Expatria-Technologies/EST_Accessory_PCB/README.md

flag

# Elbows up.
