Expatria-Technologies/EST_Accessory_PCB/LIMIT_BREAKOUT/CAM_OUTPUTS/BOM/LIMIT_SW_Breakout_CAM_OUTPUT_A8.xlsx

Comment | Description | Designator | Footprint | SuppliersPartNumber | Quantity
0805 Green | LED | D24 | 0805_LED_S1 | C2297 | 1
0603 Yellow | LED | D25, D26, D27, D28 | 0603_LED_S1 | C72038 | 4
0603 White | LED | D29, D30 | 0603_LED_S1 | C2290 | 2
 | Header,Male Pin,Covered(4 Sided) 3 1 0.138"（3.50mm） 3 P=3.5mm Pluggable System Terminal Block RoHS | J17, J18, J19, J20, J21, J22 | SL_3_50_180G_03 | C192778 | 6
5555799-1 | CONN MOD JACK 8P8C VERT UNSHLD | J23 | FP-5555799-1-MFG | C305983 | 1
AP5N10S | N Mosfet | Q1, Q2 | SOT-23-3L | C2849571 | 2
MMBT5401 2L | 三极管 | Q3, Q4 | SOT-23(SOT-23-3) | C8326 | 2
100KΩ ±1% | Chip resistor | R1, R2 | 0603_R | C25803 | 2
2KΩ ±1% | Chip resistor | R3, R4, R79, R80, R81, R82, R83, R84 | 0603_R | C22975 | 8
10KΩ ±1% | Chip resistor | R78 | 0603_R | C25804 | 1
