Expatria-Technologies/EST_Accessory_PCB/USER_BREAKOUT/CAM_OUTPUTS/BOM/USER_SW_Breakout_CAM_OUTPUT_A7.xlsx

Comment | Description | Designator | Footprint | SuppliersPartNumber | Quantity
0603 Green | LED | D31 | 0603_LED_S1 | C72043 | 1
0603 Red | LED | D32 | 0603_LED_S1 | C2286 | 1
0603 Yellow | LED | D33, D34 | 0603_LED_S1 | C72038 | 2
RJHSE-5080 | CONN MOD JACK 8P8C R/A UNSHLD | J24 | FP-RJHSE-5080-MFG | C385834 | 1
AO3400A N | MOS(场效应管) | Q1, Q2, Q3 | SOT-23-3L | C700953 | 3
2KΩ ±1% | Chip resistor | R1, R2, R3, R85, R87, R89, R90 | 0603_R | C22975 | 7
K2-1102SP-C4SC-04 | Top Actuated 50mA @ 12VDC Round Button SPST 6*6mm Tactile Switches ROHS | SW1, SW2, SW3 | TECO-FSM4JSMATR_V | C127509 | 3
