Expatria-Technologies/EST_Accessory_PCB/LED_RING/LED_Ring_80mm.step

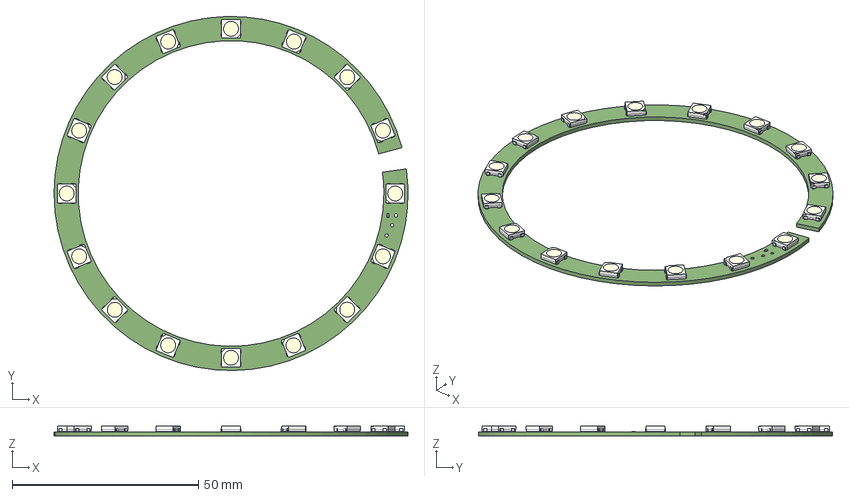
[picture p9: CAD file, 2025-03-02]
LED_RING/LED_Ring_80mm.step
95.0 x 95.0 x 2.77 mm
User_Library-WS2812B x 16
0402_SMD_Capacitor
