Expatria-Technologies/EST_Accessory_PCB/LIMIT_BREAKOUT/LIMIT_SW_Breakout.step

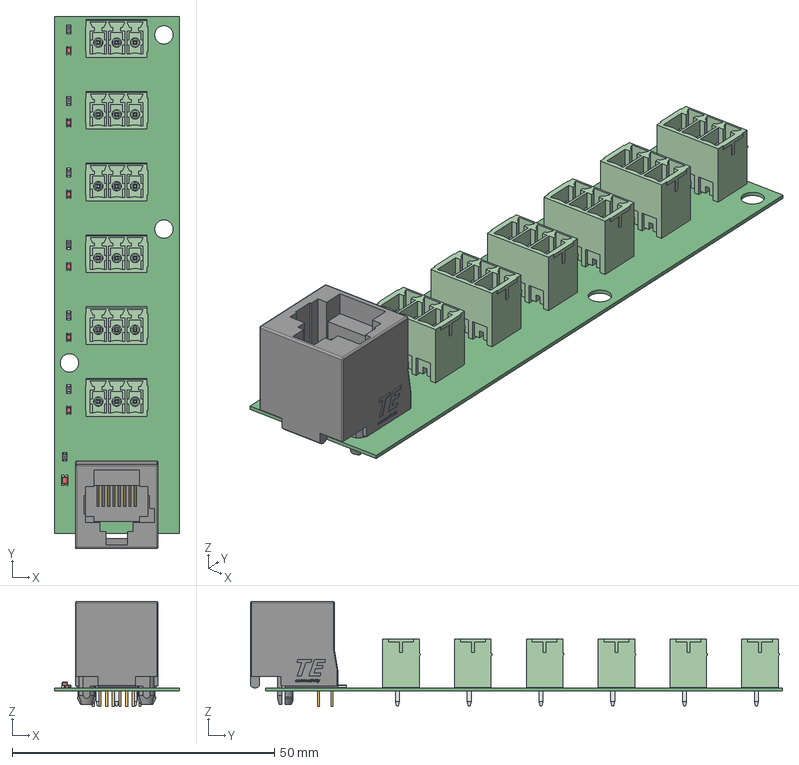
[picture p10: CAD file, 2023-08-02]
LIMIT_BREAKOUT/LIMIT_SW_Breakout.step
23.9 x 101.4 x 20.1 mm
plastic
pins_
User_Library-RES_1609-0603 x 7
6913211000xx_PIN x 18
User_Library-LED_0603_R_Pocket002 x 6
User_Library-LED_0603_R_Pad004 x 6
User_Library-LED_0603_R_Fillet x 6
User_Library-LED_0603_R_Pocket001 x 6
User_Library-LED_0603_R_Pad x 6
User_Library-led_0805
