Expatria-Technologies/EST_Accessory_PCB/USER_BREAKOUT/USER_SW_Breakout.step

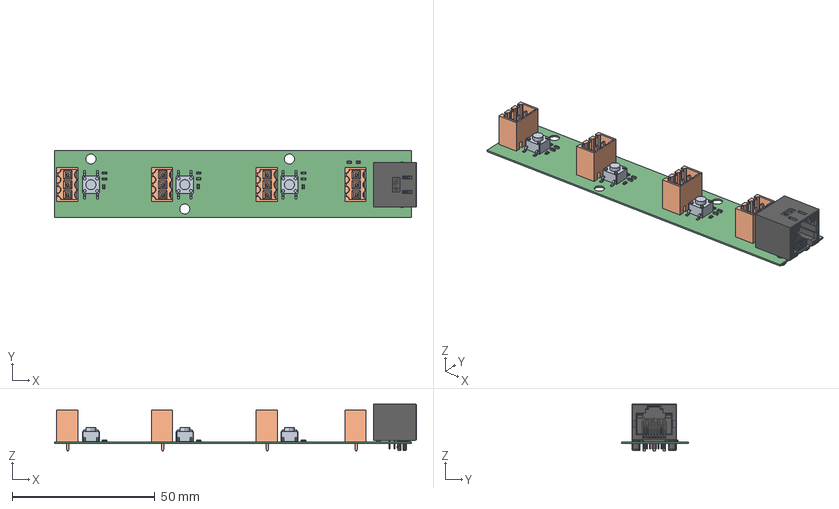
[picture p11: CAD file, 2023-08-02]
USER_BREAKOUT/USER_SW_Breakout.step
126.7 x 23.5 x 16.4 mm
Conn_Amphenol_RJHSE-5080_eec
c-4-1437565-2-s-3d x 3
User_Library-RES_1609-0603 x 7
SL_3.50_03_180G_3.2SN_OR_BX_1604480000 x 4
User_Library-LED_0603_R_Pocket002 x 4
User_Library-LED_0603_R_Pad004 x 4
User_Library-LED_0603_R_Fillet x 4
User_Library-LED_0603_R_Pocket001 x 4
User_Library-LED_0603_R_Pad x 4
