Expatria-Technologies/EST_Accessory_PCB/LIMIT_BREAKOUT/LIMIT_SW_Breakout_Schematic_A7_FULL_ASSEMBLY.PDF

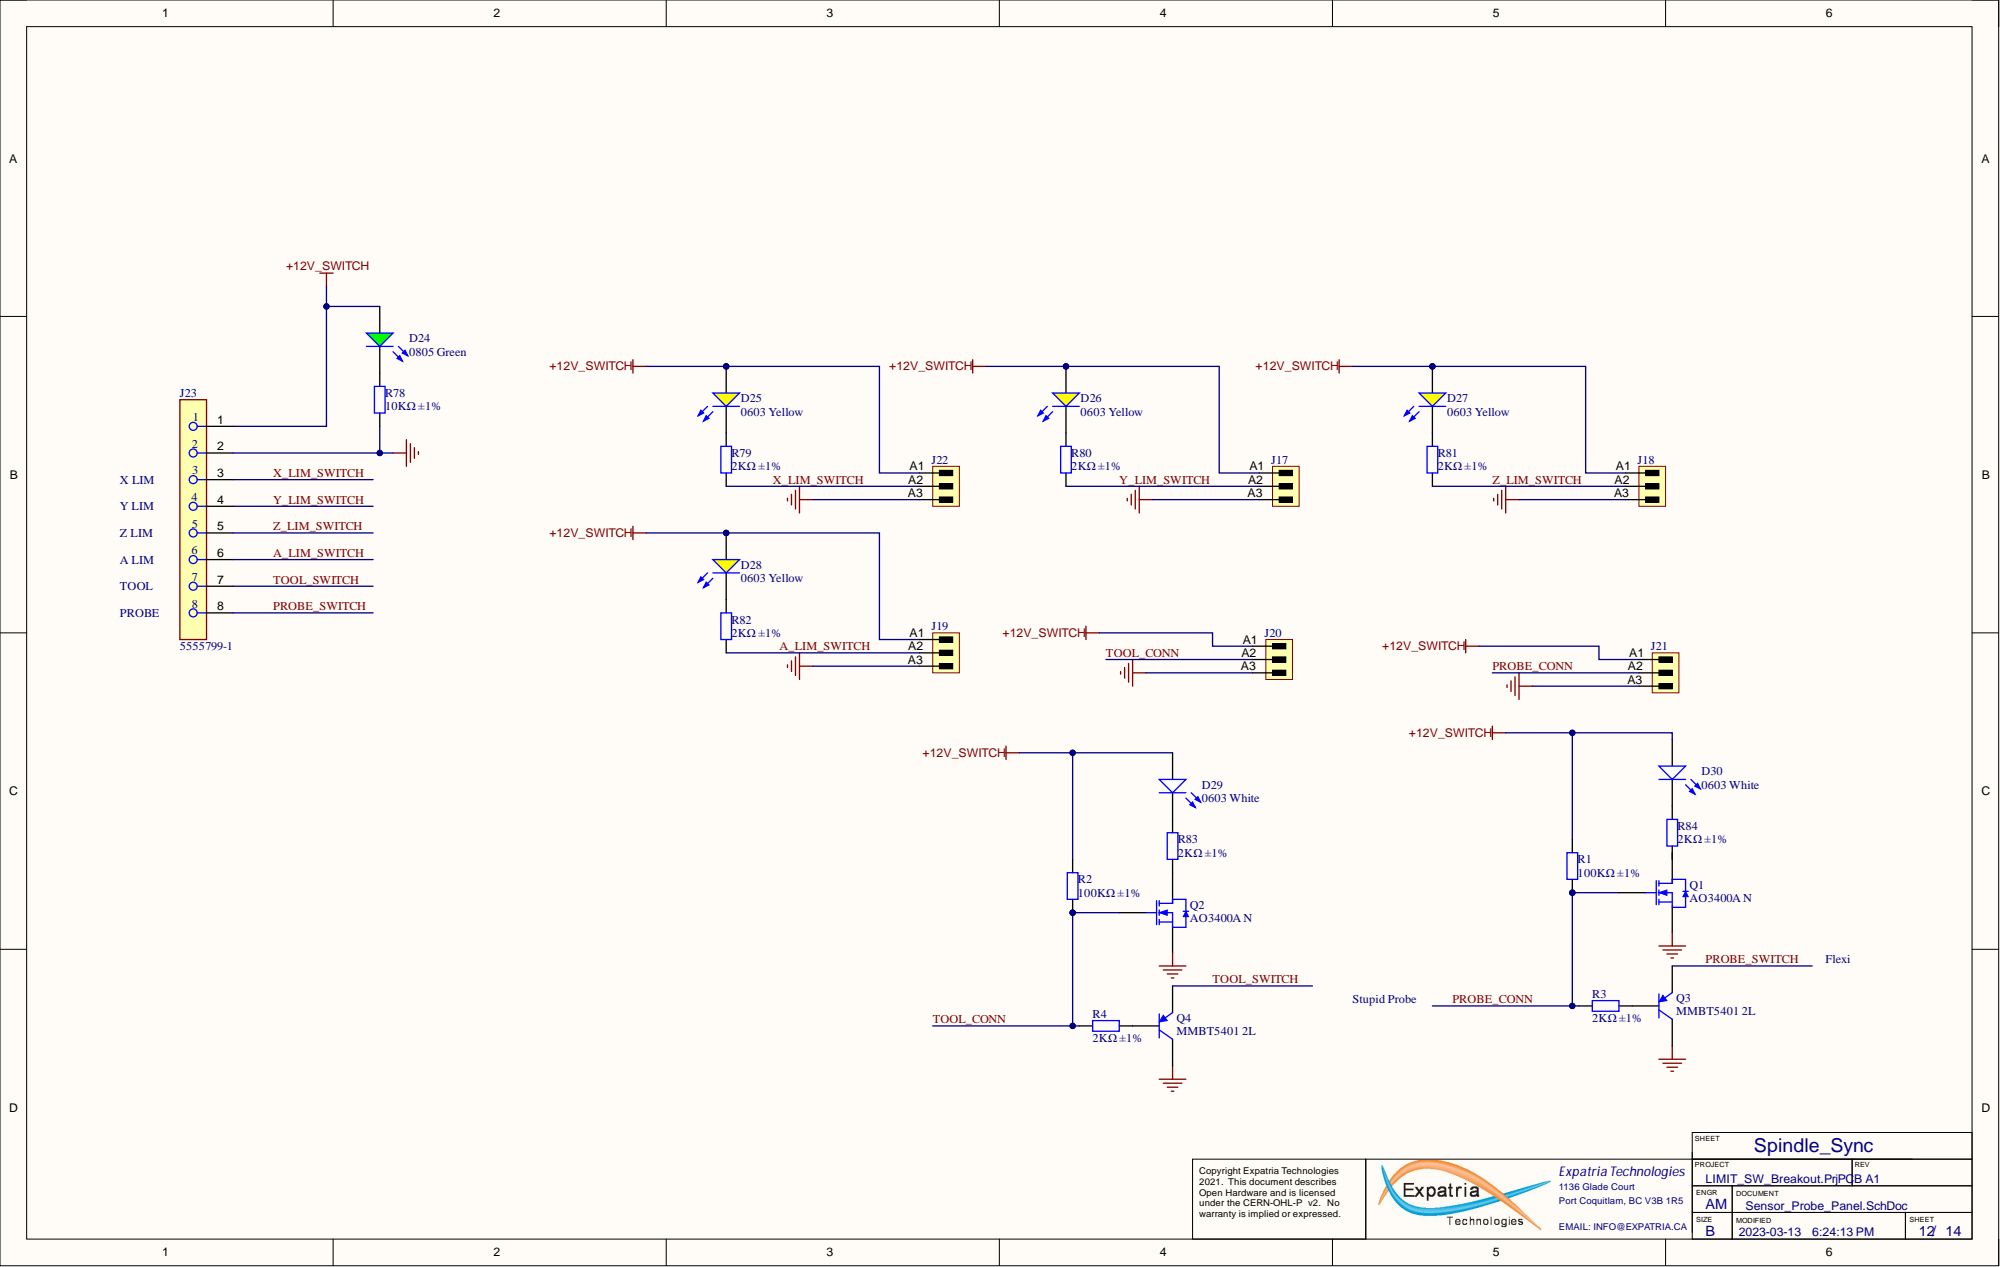
[picture p12: page 1]

X LIM Y LIM Z LIM A LIM TOOL

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

E N G R A M | D O C U M E N T Sensor_Probe_Panel.Sc h D o c
