Expatria-Technologies/EST_Accessory_PCB/(list of files, drawings)

Other design files:
ENCODER_BREAKOUT/Flexi_encoder_BOB.PrjPCB
ENCODER_BREAKOUT/Layout/Flexi_encoder_BOB.pcbdoc
ENCODER_BREAKOUT/Schematic/Flexi_encoder_BOB.SchDoc
ENCODER_BREAKOUT_MK2/Flexi_encoder_BOB.PrjPCB
ENCODER_BREAKOUT_MK2/Schematic/Flexi_encoder_BOB.SchDoc
LED_RING/Layout/LED_Ring_80mm.pcbdoc
LED_RING/LED_Ring_80mm.PrjPCB
LED_RING/Schematic/LED_Ring_80mm.SchDoc
LIMIT_BREAKOUT/Layout/LIMIT_SW_Breakout.pcbdoc
LIMIT_BREAKOUT/LIMIT_SW_Breakout.PrjPCB
LIMIT_BREAKOUT/Schematic/Sensor_Probe_Panel.SchDoc
USER_BREAKOUT/Layout/USER_SW_Breakout.pcbdoc
USER_BREAKOUT/Schematic/User_Button_Panel.SchDoc
USER_BREAKOUT/USER_SW_Breakout.PrjPCB
