Expatria-Technologies/EST_Accessory_PCB/(commit log)

2023-05-10 Initial commit of current files.
    [Flexi_encoder_BOB.PrjPCB, Flexi_encoder_BOB.SchDoc, Flexi_encoder_BOB.pcbdoc, Flexi_encoder_BOB_CAM_OUTPUT_A1.csv, Flexi_encoder_BOB_CAM_OUTPUT_A1.xlsx, LIMIT_SW_Breakout.PrjPCB, LIMIT_SW_Breakout.pcbdoc, LIMIT_SW_Breakout_CAM_OUTPUT_A8.csv]
2023-08-02 Upload ENCODER_BREAKOUT step file.
    [LIMIT_SW_Breakout.step, USER_SW_Breakout.step]
2024-10-19 Updated BOM.
    [LIMIT_SW_Breakout_CAM_OUTPUT_A8.xlsx]
2024-11-06 Commit B1 encoder breakout.
    [Flexi_encoder_BOB.PrjPCB, Flexi_encoder_BOB.SchDoc]
2024-11-18 Commit small silkscreen updates (no revision increment).
    [Flexi_encoder_BOB.PrjPCB, Flexi_encoder_BOB.SchDoc]
2024-11-27 Commit encoder BOB Mk2
    [Flexi_encoder_BOB.SchDoc]
2024-11-27 Initial commit of 80mm LED ring.
    [LED_Ring_80mm.PrjPCB, LED_Ring_80mm.SchDoc, LED_Ring_80mm.pcbdoc]
2025-03-02 commit step files.
    [LED_Ring_80mm.step]
