Expatria-Technologies/EST_Accessory_PCB/(notices)

Notices in the files:
LIMIT_BREAKOUT/LIMIT_SW_Breakout_Schematic_A7_FULL_ASSEMBLY.PDF:
Co p yri g ht Ex p atri a Te c h n o l o g i e s 2 0 2 1. Th i s d o c u m e nt d e s cri b e s O p e n Hardware a n d i s l i c e n s e d u n d er th e CERN-OHL-P v 2. No warra nty i s i m p l i e d or e x pre s s e d . | | P R OJE C T LI M I T_SW_Breakout . P rj P C | R E V B A1
